royshearer/niftymitter/niftymitter 0.23 electronics schematic.png

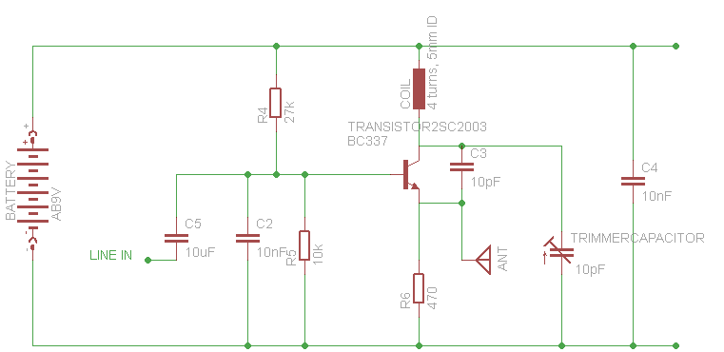
niftymitter 0.23 electronics schematic.png
