royshearer/niftymitter/niftymitter PCB v0.24.png

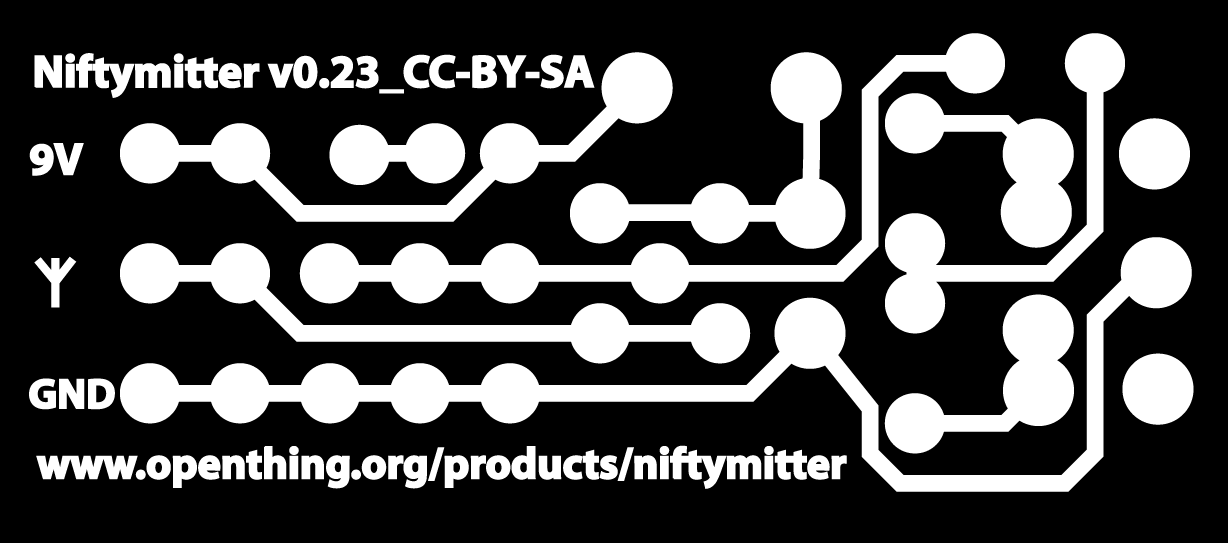
niftymitter PCB v0.24.png
