royshearer/niftymitter/niftymitter v0.25 parts list.xls

Part List
Part | Qty | ABR | rapid ref | basic unit cost
Miniature SPST LED latching push switch (http://www.thingiverse.com/part:691) | 1 | S1 | 78-0188 (http://www.rapidonline.com/productinfo.aspx?catref=78-0188) | £0.83
niftymitter_0.24_housing.svg | 1
niftymitter_PCB_v0.24.svg | 1
Coil (http://www.thingiverse.com/part:846) | 1 | CO
4.2- 20pf Trimmer capacitor | 1 | TC | 12-0140 | 0.23
27k resistor (http://www.thingiverse.com/part:848) | 1 | R1 | 62-0404 | 0.005
10pF ceramic capacitor (http://www.thingiverse.com/part:850) | 1 | C3 | 08-0040 (http://www.rapidonline.com/productinfo.aspx?catref=08-0040) | £0.01
10nF ceramic capacitor (http://www.thingiverse.com/part:854) | 2 | C2, C4 | 08-0230 | £0.01
10uF electrolytic capacitor (http://www.thingiverse.com/part:849) | 1 | C1 | 11-0840 (http://www.rapidonline.com/productinfo.aspx?catref=11-0840) | £0.02
10K ohm resistor (http://www.thingiverse.com/part:56) | 3 | R2, R4, R5 | 64-0098 (https://www.rapidonline.com/productinfo.aspx?catref=64-0098) | 0.006
470 ohm resistor (http://www.thingiverse.com/part:853) | 1 | R3 | 62-0797 (http://www.rapidonline.com/productinfo.aspx?catref=62-0797) | 0.01
BC337 Transistor (http://www.thingiverse.com/part:851) | 1 | TR | 81-0472 (http://www.rapidonline.com/productinfo.aspx?catref=81-0472) | £0.05
stereo 3.5mm jack socket | 1 |  | 20-0157 (http://www.rapidonline.com/Cables-Connectors/Connectors-Audio-Video/Jack/3.5mm-Stereo-PCB-jack-socket/63497/kw/20-0157) | 0.3
PP3 clip (http://www.thingiverse.com/part:855) | 1 |  | 18-0092 (http://www.rapidonline.com/Electrical-Power/Batteries/Contacts-Clips/Heavy-duty-PP3-battery-clips-with-stripped-and-tinned-ends/62284/kw/18-0092) | 0.14
50k var resistor | 1 |  | 68-0244 (http://www.rapidonline.com/productinfo.aspx?catref=68-0244) | £0.54
TOTAL |  |  |  | 2.151
alternative trimcap | 1 | tc | 12-0105 (http://www.rapidonline.com/productinfo.aspx?catref=12-0105) | £0.44
