royshearer/niftymitter/Assembling-a-Niftymitter-board-a-short-range-FM-.pdf

http://www.instructables.com/id/Assembling-a-Niftymitter-board-a-short-range-FM-/

# Assembling a Niftymitter v0.24 board - a short range FM transmitter

by royshearer (http://www.instructables.com/member/royshearer/?utm_source=pdf&utm_campaign=title) on December 1, 2009

Table of Contents

## License: Attribution Share Alike (by-sa) (http://creativecommons.org/licenses/by-sa/2.5/)

## Intro: Assembling a Niftymitter v0.24 board - a short range FM transmitter

This Instructable will guide you through assembling the circuit for Niftymitter (http://www.openthing.org) , an open source mini FM transmitter. The circuit uses a free running oscillator and is based on Tetsuo Kogawa's Simplest FM transmitter (http://www.translocal.jp/radio/micro/howtosimplestTX.html) .

The project is housed at www.openthing.org/products/niftymitter

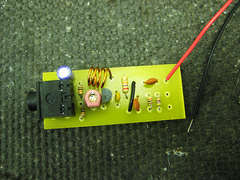
[picture p3: figure]

## step 1: What you need

Complete Parts List (http://niftymitter.googlecode.com/files/niftymitter%20v0.24%20parts%20list.xls) [.xls]

PCB Layout v0.24 (http://code.google.com/p/niftymitter/downloads/list) [.png]

The PCB source is designed for etching onto copperplate, using iron on acetate (such as that described here) (http://www.instructables.com/id/Mostly-easy-PCB-manufacture/) or using Michael Shorter's laser engraving method described here (http://www.instructables.com/id/Printed-Circuit-Boards-PCB-using-the-Laser-Cutte/) [instructables].
Circuit assembly diagram (http://code.google.com/p/niftymitter/downloads/list) for etched PCB [.png]
You will also need the following tools: Soldering iron, kit and solder. Wire snips.

## File Downloads

niftymitter v0.24 parts list.xls (http://www.instructables.com/files/orig/F7K/Z3FV/G33OQAFQ/F7KZ3FVG33OQAFQ.xls) (25 KB)
[NOTE: When saving, if you see .tmp as the file ext, rename it to 'niftymitter v0.24 parts list.xls'] (http://www.instructables.com/files/orig/F7K/Z3FV/G33OQAFQ/F7KZ3FVG33OQAFQ.xls)

## step 2: Solder on the resistors and capacitors

Place comonents flush up against the board from above. After soldering the legs onto the pads, trim of the excess.
Start by soldering all the resistors. Follow with all the capacitors and the jumper lead. Ensure that the electrolytic capacitor is oriented as described on the circuit layout diagram, the negative side away from the socket.

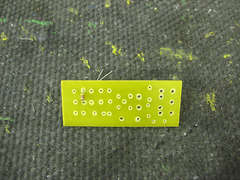
[picture p4: figure]
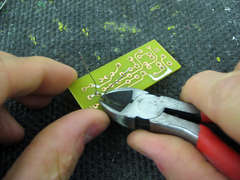
[picture p5: figure]

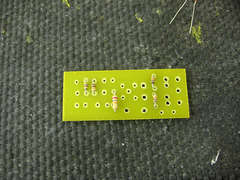
[picture p6: figure]
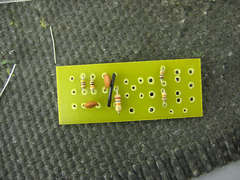
[picture p7: figure]
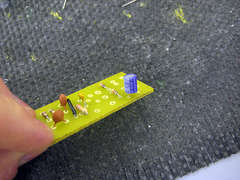
[picture p8: figure]

## step 3: Solder on the socket, coil and trimcap

Next solder on the socket. Take care to ensure the socket is solidly soldered on. Solder on the trimcap, taking care to orient the flat side as shown. Then add the coil. The instructable for making the coils is here (http://www.instructables.com/id/Making-a-Simple-Induction-Coil/) .

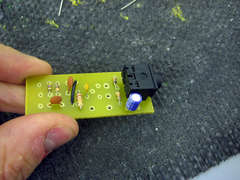
[picture p9: figure]
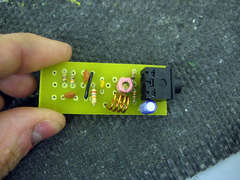
[picture p10: figure]

## step 4: Solder on the transistor

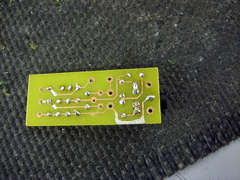
[picture p11: figure]

Finally add the transistor, taking care to orient the pins correctly.

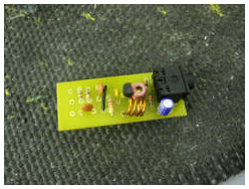
[picture p12: figure]

## step 5: Add the power connections

Solder on the positive lead from the PP3 clip to +9V. Add a short length of wire to the ground connection.

## step 6: Prepare the switch

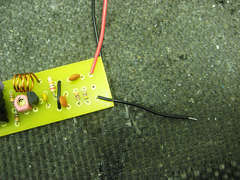
[picture p13: figure]

Bend the positive lead of the switch LED around one of the switch pole legs as shown. Solder and trim the LED leg as shown. Bend over the remaining LED leg to make a loop.

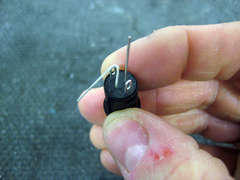
[picture p14: figure]
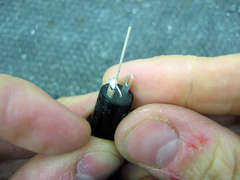
[picture p15: figure]
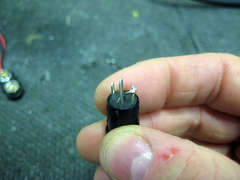
[picture p16: figure]

Advertisements
