royshearer/niftymitter/niftymitter circuit assembly v0.24.png

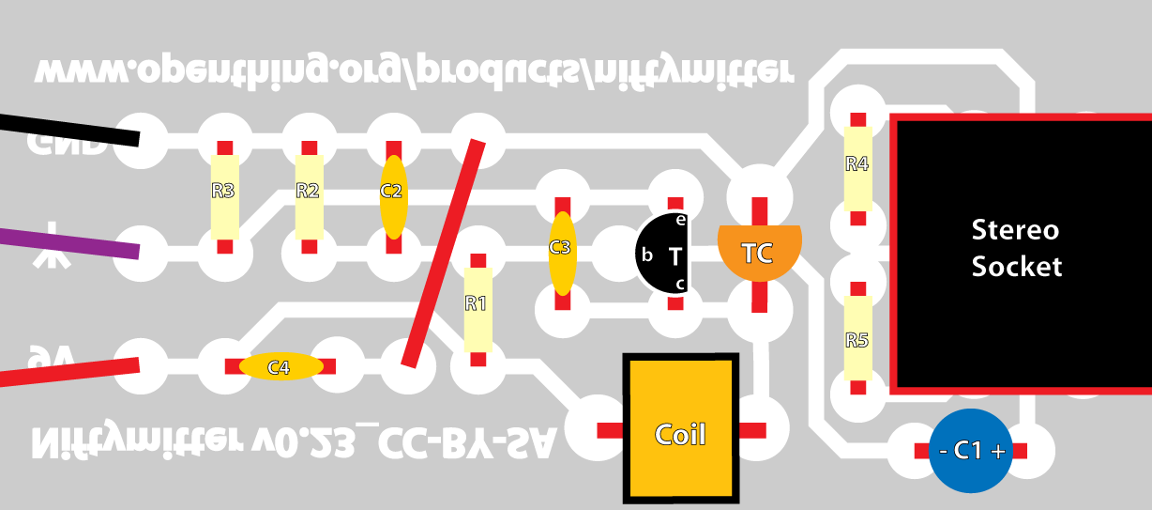
niftymitter circuit assembly v0.24.png
